senwerks/digispark-volume-knob/Lid v1.stl

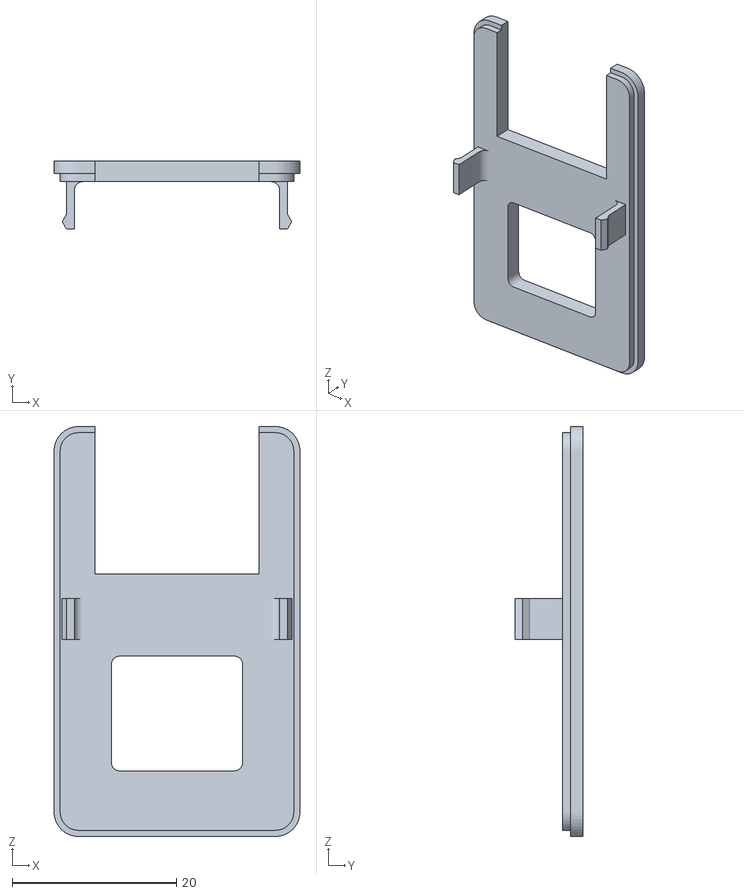
[picture p6: CAD file, 2021-05-12]
Lid v1.stl
30.0 x 8.23 x 50.0
