senwerks/digispark-volume-knob/Knob v1.stl

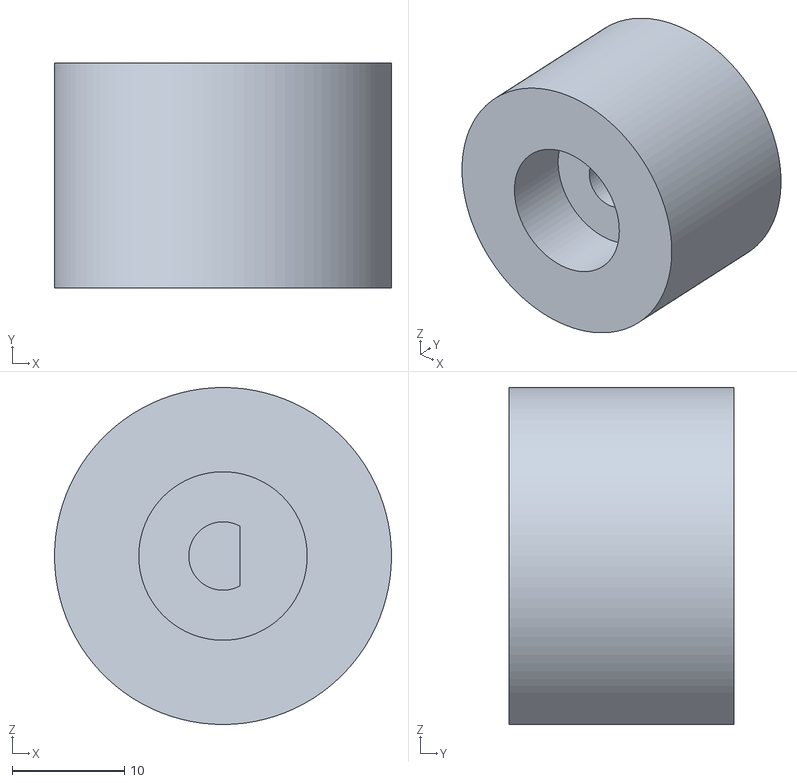
[picture p7: CAD file, 2021-05-12]
Knob v1.stl
30.0 x 20.0 x 30.0
