senwerks/digispark-volume-knob/Chassis v1.stl

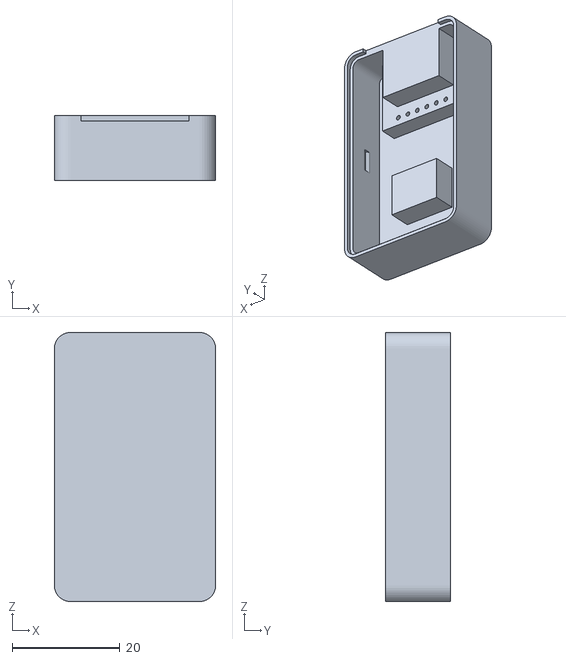
[picture p8: CAD file, 2021-05-12]
Chassis v1.stl
30.0 x 12.0 x 50.0
